benvonhandorf/minstro/README.md

# minstro
Remote control head for SDRs using the SoapyRemote server
