benvonhandorf/minstro/hardware/prototype/minstro_combined_board/minstro_combined_board.kicad_pcb

## KiCad design hardware/prototype/minstro_combined_board/minstro_combined_board.kicad_pcb (2025-06-26)

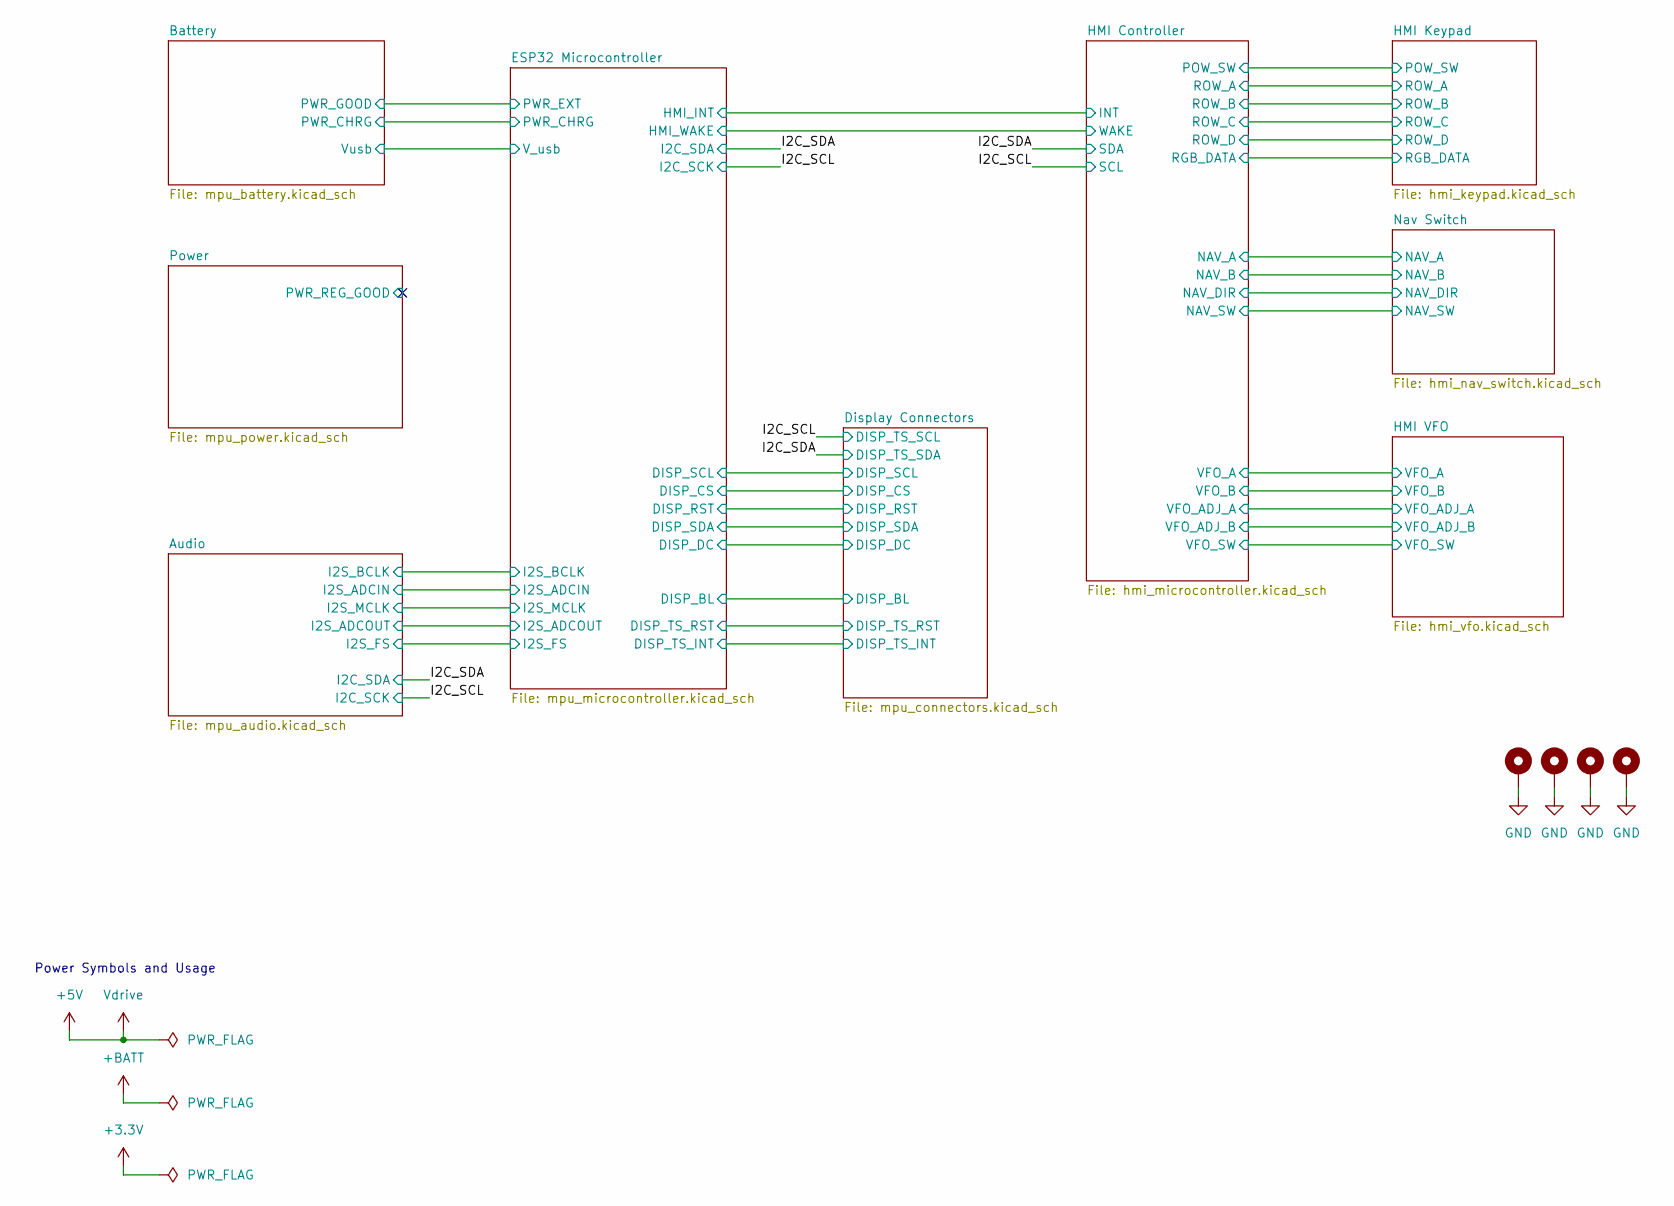
[picture p1: schematic minstro_combined_board.kicad_sch]

Parts:
H101, H102, H103, H104: MountingHole_Pad_MP; MountingHole_3.2mm_M3_Pad

Connections:
GND: H101.1, H102.1, H103.1, H104.1; also elsewhere on the board

Notes on the sheet:
Power Symbols and Usage

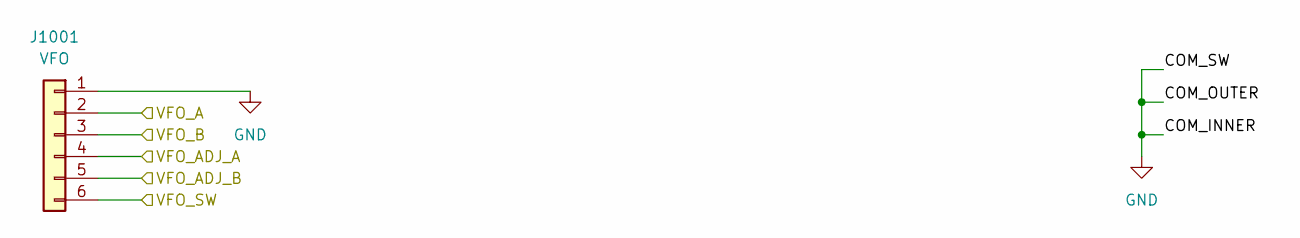
[picture p2: schematic hmi_vfo.kicad_sch]

Parts:
J1001: VFO; PinHeader_1x06_P2.54mm_Vertical

Connections:
/HMI Controller/VFO_A: J1001.2; also elsewhere on the board
/HMI Controller/VFO_ADJ_A: J1001.4; also elsewhere on the board
/HMI Controller/VFO_ADJ_B: J1001.5; also elsewhere on the board
/HMI Controller/VFO_B: J1001.3; also elsewhere on the board
/HMI Controller/VFO_SW: J1001.6; also elsewhere on the board
GND: J1001.1; also elsewhere on the board

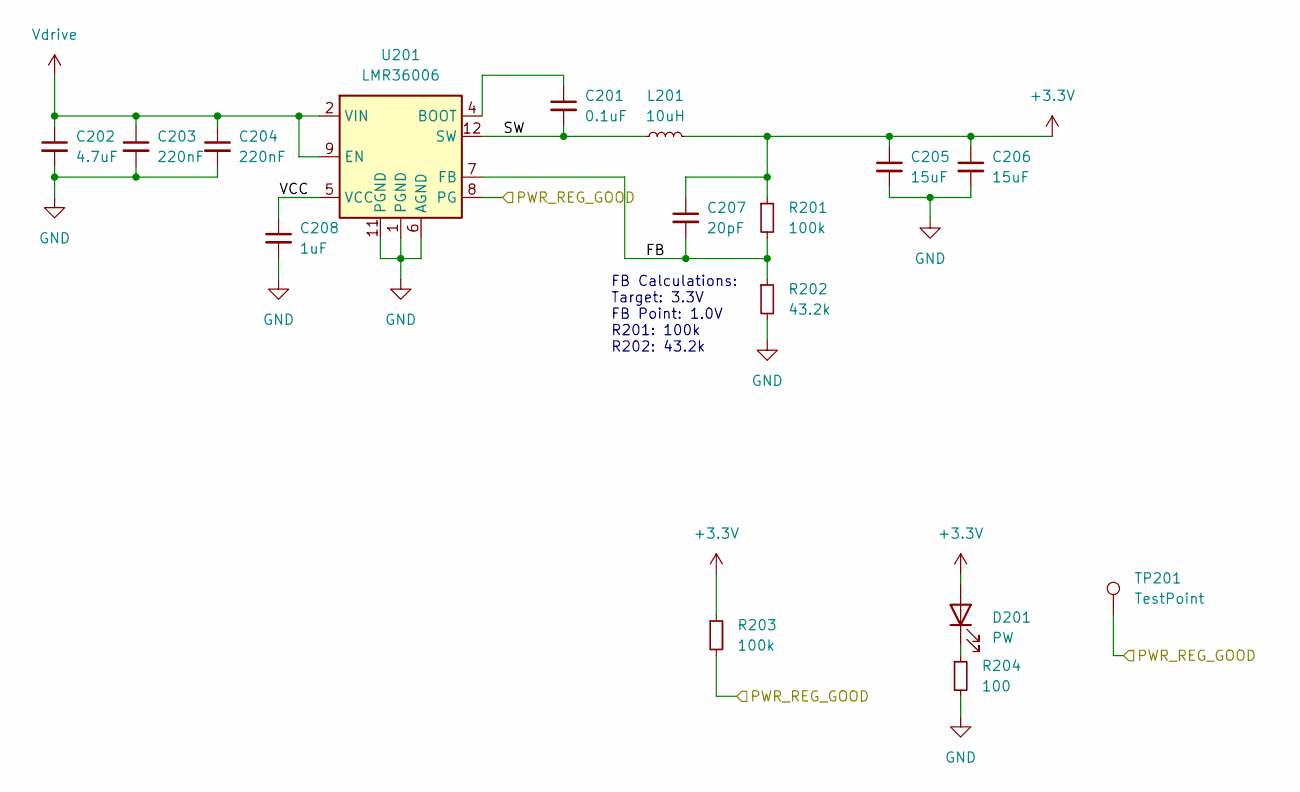
[picture p3: schematic mpu_power.kicad_sch]

Parts:
C201: 0.1uF; C_1206_3216Metric
C202: 4.7uF; C_1206_3216Metric
C203, C204: 220nF; C_1206_3216Metric
C205, C206: 15uF; C_1206_3216Metric
C207: 20pF; C_0805_2012Metric
C208: 1uF; C_0805_2012Metric
D201: PW; LED_0805_2012Metric
L201: 10uH; L_Taiyo-Yuden_MD-4040
R201, R203: 100k; R_0603_1608Metric
R202: 43.2k; R_0603_1608Metric
R204: 100; R_0603_1608Metric
TP201: TestPoint; TestPoint_Pad_D1.5mm
U201: LMR36006; LMR36006-VQFN-HR

Connections:
+3.3V: C205.1, C206.1, C207.1, D201.2 (A), L201.2, R201.1, R203.1; also elsewhere on the board
/Power/FB: C207.2, R201.2, R202.1, U201.7 (FB)
/Power/PWR_REG_GOOD: R203.2, TP201.1, U201.8 (PG)
/Power/SW: C201.2, L201.1, U201.3 (SW), U201.12 (SW)
/Power/VCC: C208.1, U201.5 (VCC)
GND: C202.2, C203.2, C204.2, C205.2, C206.2, C208.2, R202.2, R204.2, U201.1 (PGND), U201.6 (AGND), U201.11 (PGND); also elsewhere on the board
unnamed: D201.1 (K), R204.1
unnamed: C201.1, U201.4 (BOOT)

Notes on the sheet:
FB Calculations: Target: 3.3V FB Point: 1.0V R201: 100k R202: 43.2k

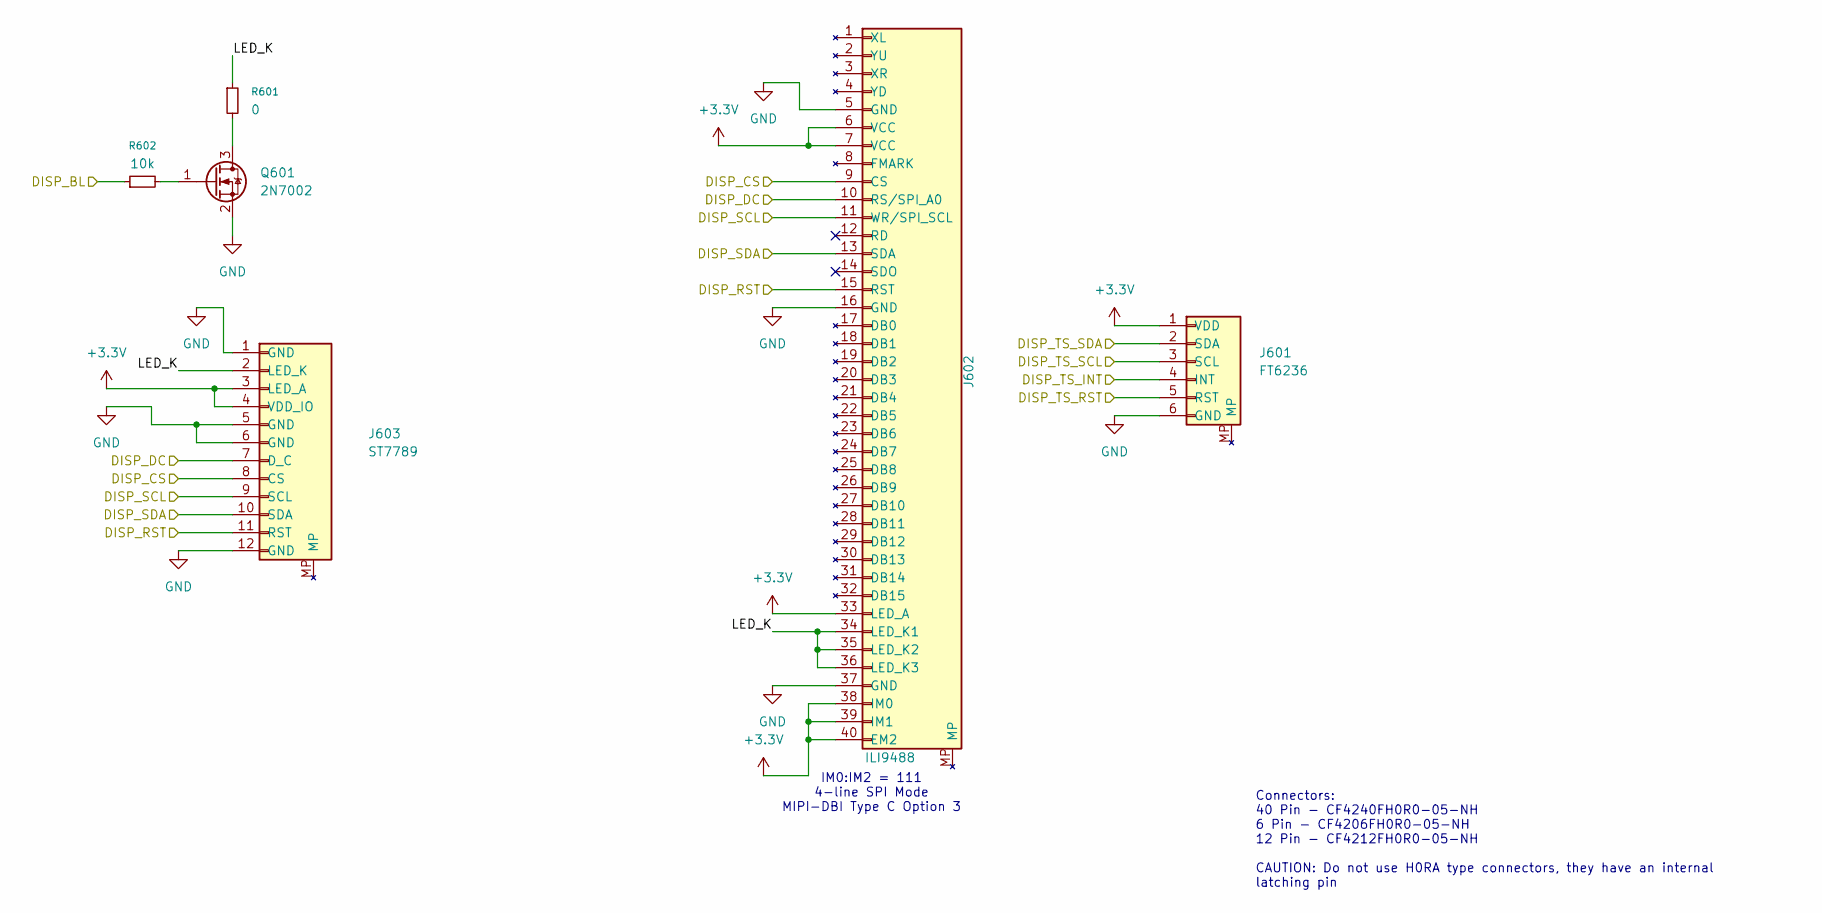
[picture p4: schematic mpu_connectors.kicad_sch]

Parts:
J601: FT6236; Cvilux_CF4206FH0R0-05-NH_FFC_01x06-1MP_P0.5mm_Horizontal
J602: ILI9488; Cvilux_CF4240FH0R0-05-NH_FFC_01x40-1MP_P0.5mm_Horizontal
J603: ST7789; Cvilux_CF4212FH0R0-05-NH_FFC_01x12-1MP_P0.5mm_Horizontal_1
Q601: 2N7002; SOT-23
R601: 0; R_0603_1608Metric_Pad0.98x0.95mm_HandSolder
R602: 10k; R_0603_1608Metric_Pad0.98x0.95mm_HandSolder

Connections:
+3.3V: J601.1 (VDD), J602.6 (VCC), J602.7 (VCC), J602.33 (LED_A), J602.38 (IM0), J602.39 (IM1), J602.40 (EM2), J603.3 (LED_A), J603.4 (VDD_IO); also elsewhere on the board
/Display Connectors/DISP_BL: R602.1; also elsewhere on the board
/Display Connectors/DISP_CS: J602.9 (CS), J603.8 (CS); also elsewhere on the board
/Display Connectors/DISP_DC: J602.10 (RS/SPI_A0), J603.7 (D_C); also elsewhere on the board
/Display Connectors/DISP_RST: J602.15 (RST), J603.11 (RST); also elsewhere on the board
/Display Connectors/DISP_SCL: J602.11 (WR/SPI_SCL), J603.9 (SCL); also elsewhere on the board
/Display Connectors/DISP_SDA: J602.13 (SDA), J603.10 (SDA); also elsewhere on the board
/Display Connectors/DISP_TS_INT: J601.4 (INT); also elsewhere on the board
/Display Connectors/DISP_TS_RST: J601.5 (RST); also elsewhere on the board
/Display Connectors/LED_K: J602.34 (LED_K1), J602.35 (LED_K2), J602.36 (LED_K3), J603.2 (LED_K), R601.1
/I2C_SCL: J601.3 (SCL); also elsewhere on the board
/I2C_SDA: J601.2 (SDA); also elsewhere on the board
GND: J601.6 (GND), J602.5 (GND), J602.16 (GND), J602.37 (GND), J603.1 (GND), J603.5 (GND), J603.6 (GND), J603.12 (GND), Q601.2 (S); also elsewhere on the board
unnamed: Q601.3 (D), R601.2
unnamed: Q601.1 (G), R602.2

Notes on the sheet:
IM0:IM2 = 111 4-line SPI Mode MIPI-DBI Type C Option 3
Connectors: 40 Pin - CF4240FH0R0-05-NH 6 Pin - CF4206FH0R0-05-NH 12 Pin - CF4212FH0R0-05-NH CAUTION: Do not use H0RA type connectors, they have an internal latching pin

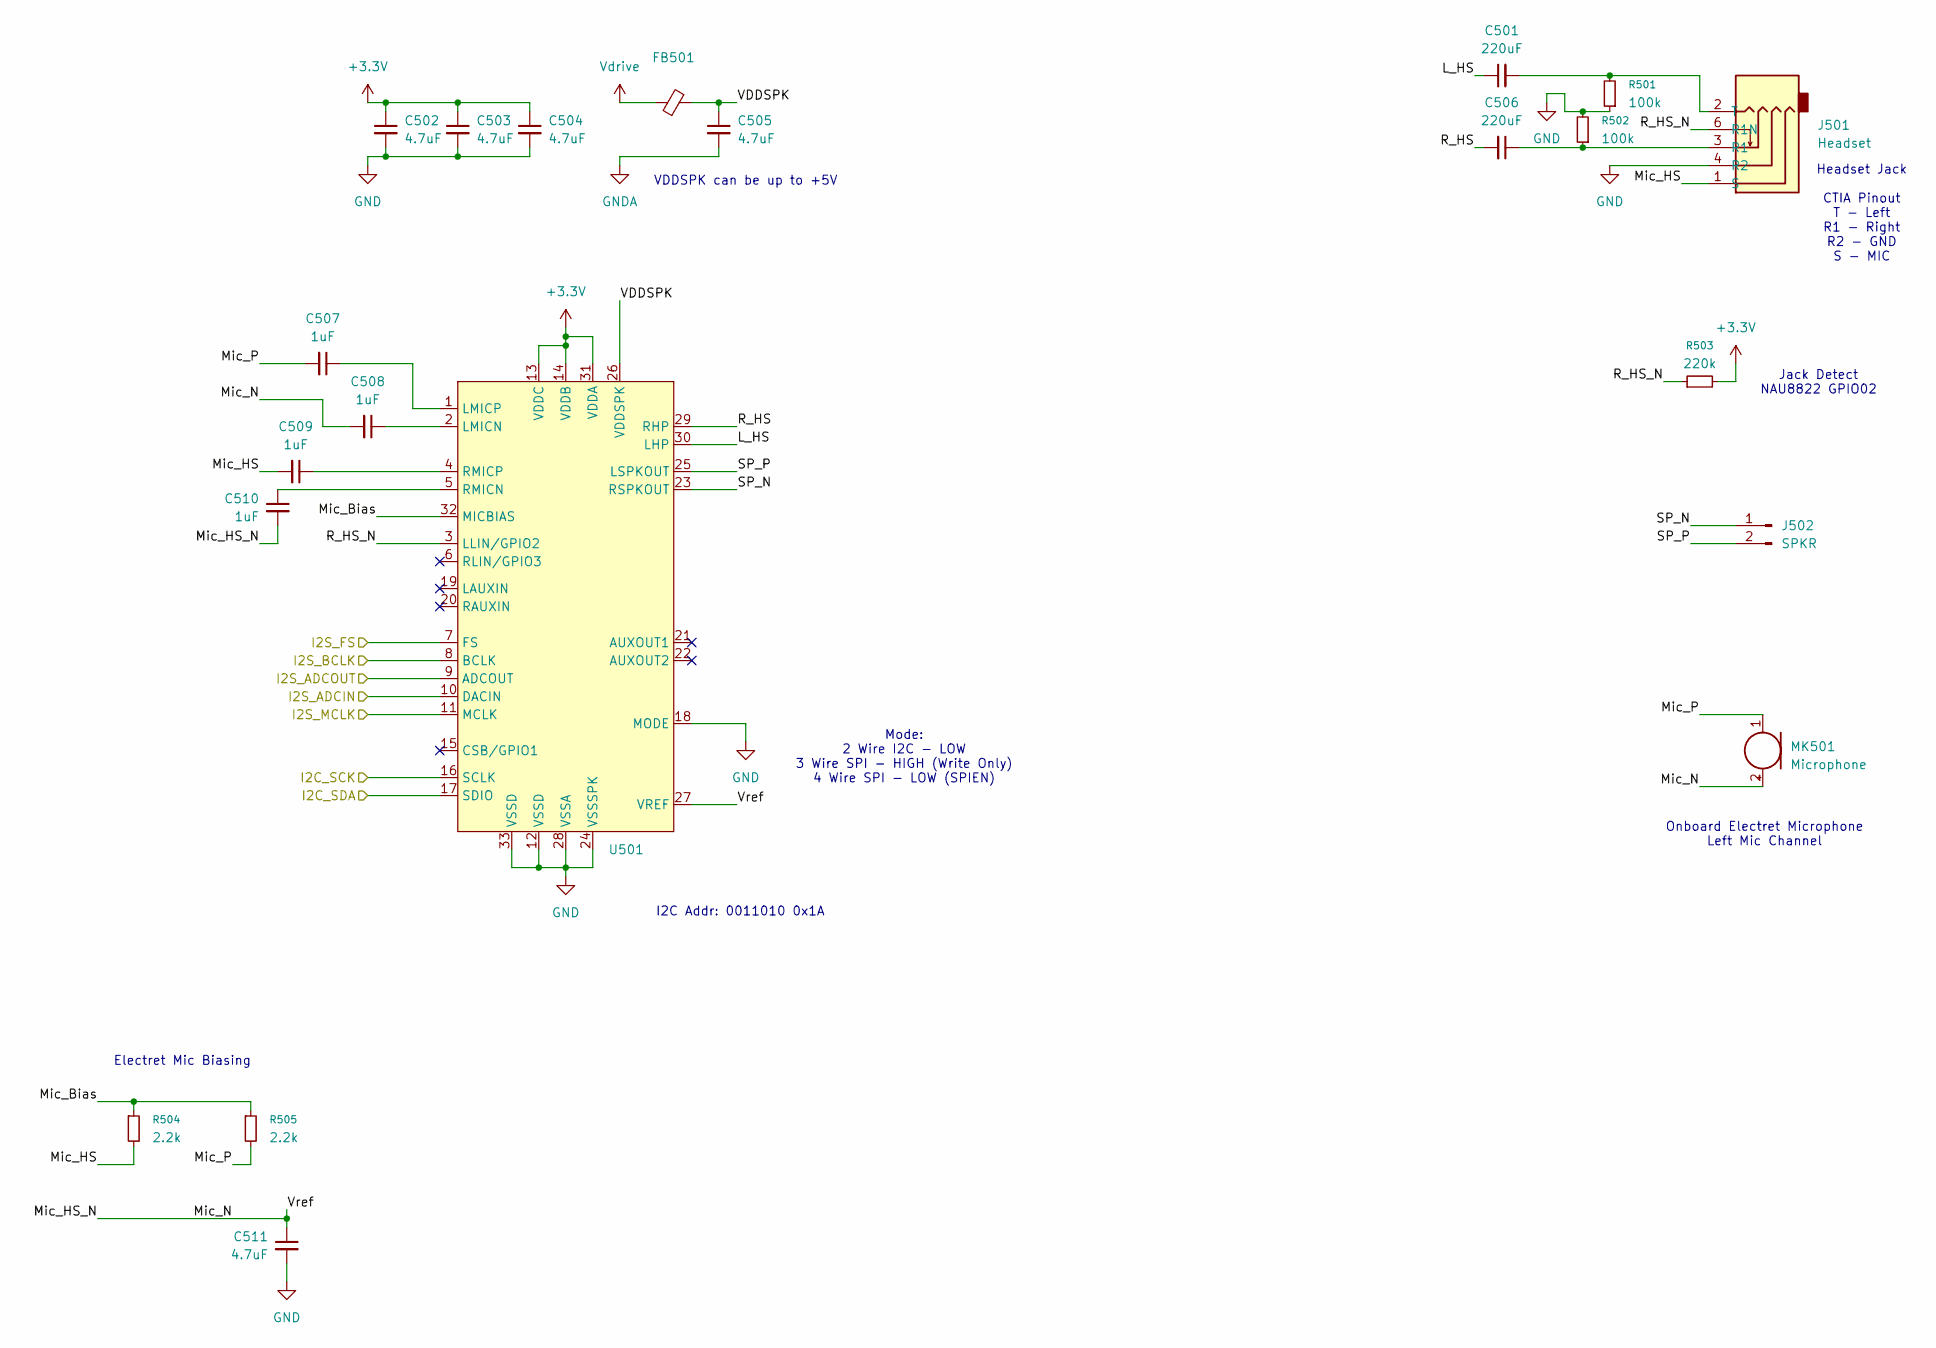
[picture p5: schematic mpu_audio.kicad_sch]

Parts:
C501, C506: 220uF; C_1210_3225Metric
C502, C503, C504, C505, C511: 4.7uF; C_0805_2012Metric
C507, C508, C509, C510: 1uF; C_0603_1608Metric
FB501: FerriteBead_Small; R_0805_2012Metric
J501: Headset; SJ-43515RS-SMT-TR
J502: SPKR; JST_ZH_B2B-ZR_1x02_P1.50mm_Vertical
MK501: Microphone; SameSky_CMB-6544PF_Electret_Mic_9.4d
R501, R502: 100k; R_0603_1608Metric
R503: 220k; R_0603_1608Metric
R504, R505: 2.2k; R_0603_1608Metric
U501: QFN-32-1EP_5x5mm_P0.5mm_EP2.7x2.7mm_ThermalVias

Connections:
+3.3V: C502.1, C503.1, C504.1, R503.2, U501.13 (VDDC), U501.14 (VDDB), U501.31 (VDDA); also elsewhere on the board
/Audio/I2S_ADCIN: U501.10 (DACIN); also elsewhere on the board
/Audio/I2S_ADCOUT: U501.9 (ADCOUT); also elsewhere on the board
/Audio/I2S_BCLK: U501.8 (BCLK); also elsewhere on the board
/Audio/I2S_FS: U501.7 (FS); also elsewhere on the board
/Audio/I2S_MCLK: U501.11 (MCLK); also elsewhere on the board
/Audio/L_HS: C501.1, U501.30 (LHP)
/Audio/Mic_Bias: R504.1, R505.1, U501.32 (MICBIAS)
/Audio/Mic_HS: C509.2, J501.1 (S), R504.2
/Audio/Mic_HS_N: C508.2, C510.2, C511.1, MK501.2 (+), U501.27 (VREF)
/Audio/Mic_P: C507.2, MK501.1 (-), R505.2
/Audio/R_HS: C506.2, U501.29 (RHP)
/Audio/R_HS_N: J501.6 (R1N), R503.1, U501.3 (LLIN/GPIO2)
/Audio/SP_N: J502.1, U501.23 (RSPKOUT)
/Audio/SP_P: J502.2, U501.25 (LSPKOUT)
/Audio/VDDSPK: C505.1, FB501.2, U501.26 (VDDSPK)
/I2C_SCL: U501.16 (SCLK); also elsewhere on the board
/I2C_SDA: U501.17 (SDIO); also elsewhere on the board
GND: C502.2, C503.2, C504.2, C511.2, J501.4 (R2), R501.1, R502.2, U501.12 (VSSD), U501.18 (MODE), U501.24 (VSSSPK), U501.28 (VSSA), U501.33 (VSSD); also elsewhere on the board
GNDA: C505.2
unnamed: C506.1, J501.3 (R1), R502.1
unnamed: C501.2, J501.2 (T), R501.2
unnamed: C508.1, U501.2 (LMICN)
unnamed: C507.1, U501.1 (LMICP)
unnamed: C510.1, U501.5 (RMICN)
unnamed: C509.1, U501.4 (RMICP)

Notes on the sheet:
Onboard Electret Microphone Left Mic Channel
VDDSPK can be up to +5V
Electret Mic Biasing
I2C Addr: 0011010 0x1A
Mode: 2 Wire I2C - LOW 3 Wire SPI - HIGH (Write Only) 4 Wire SPI - LOW (SPIEN)
Headset Jack CTIA Pinout T - Left R1 - Right R2 - GND S - MIC
Jack Detect NAU8822 GPIO02

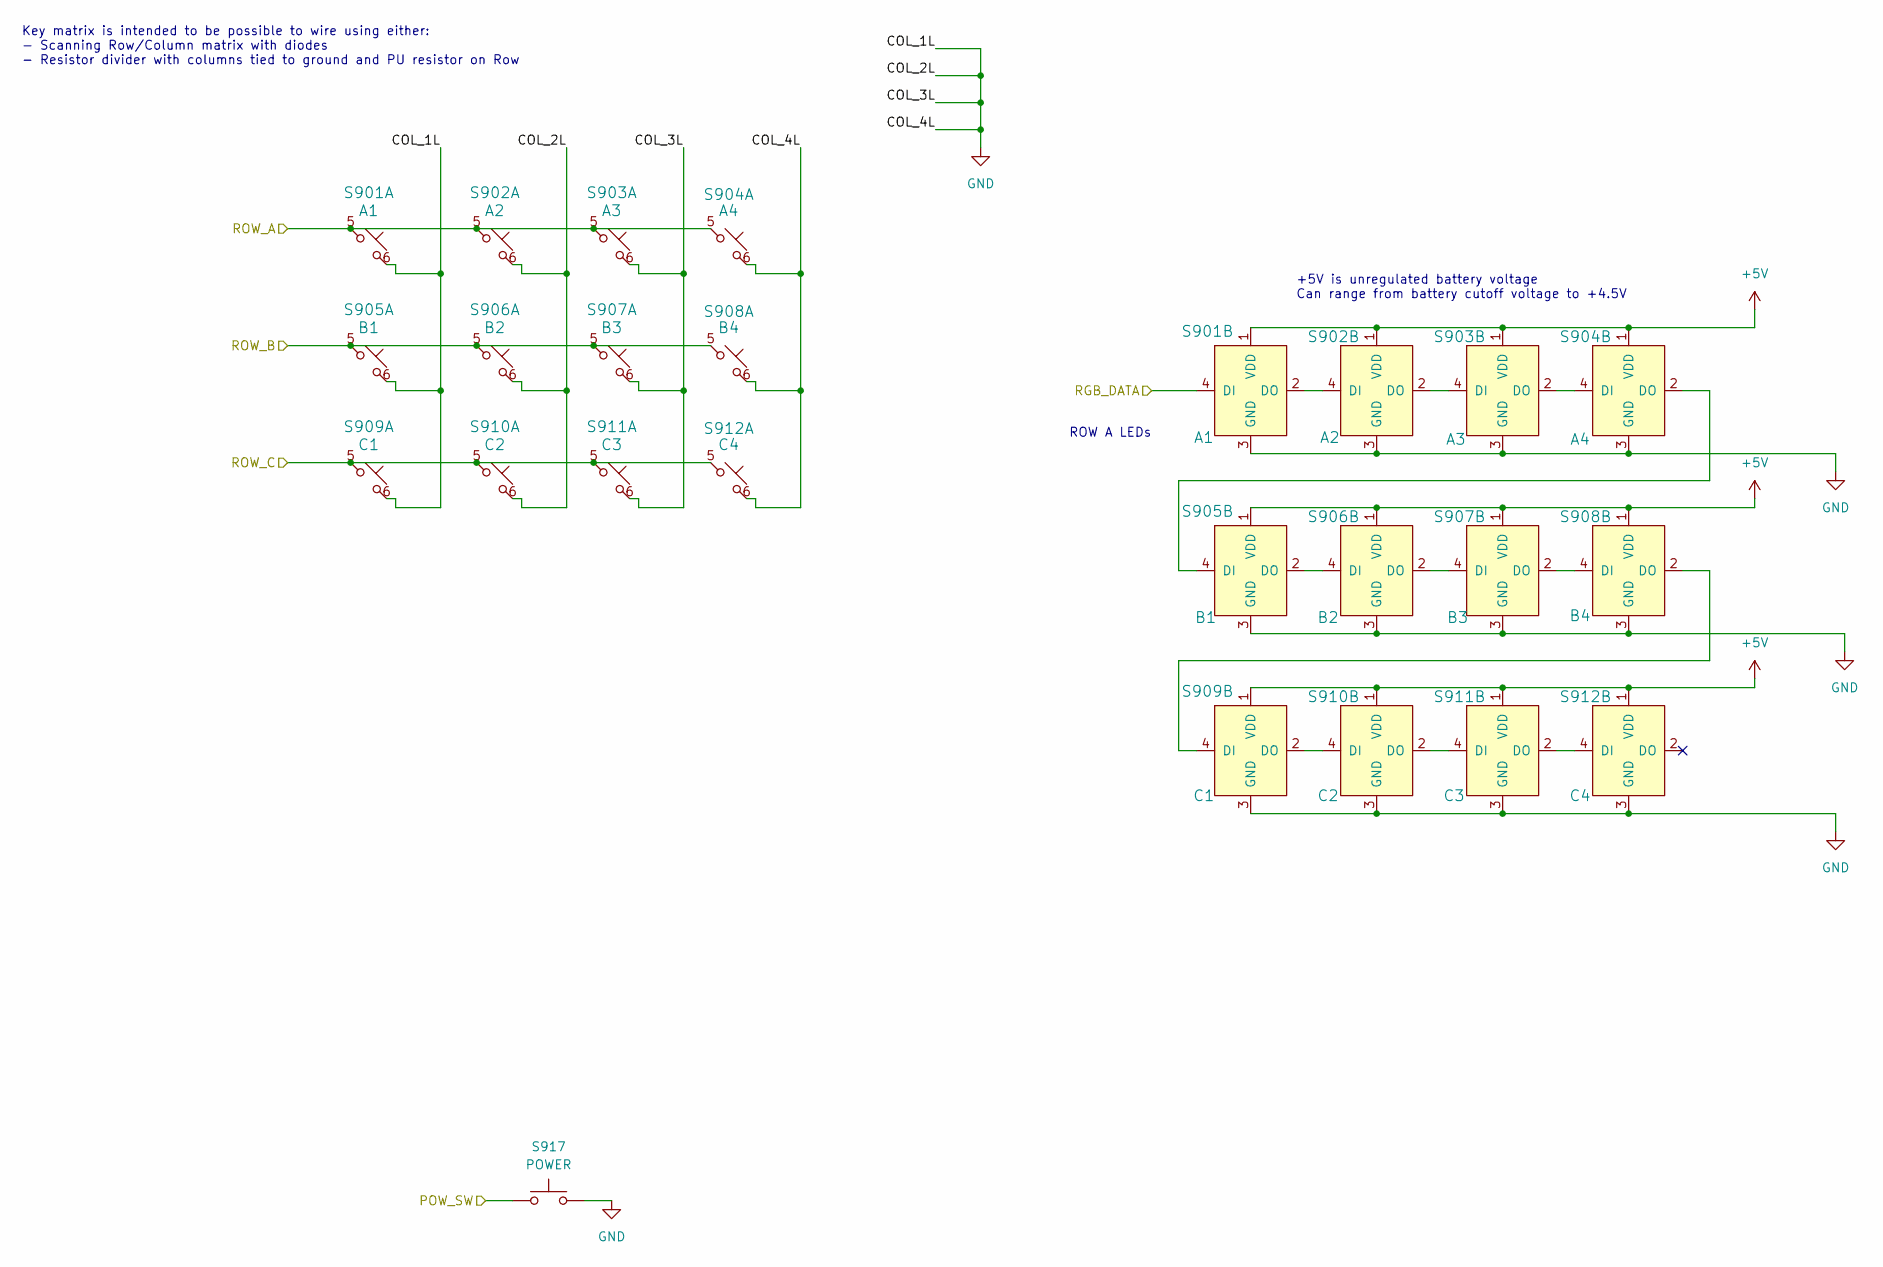
[picture p6: schematic hmi_keypad.kicad_sch]

Parts:
S901: A1; TacButton_6mm_6mm_SK6812-E-Mini
S902: A2; TacButton_6mm_6mm_SK6812-E-Mini
S903: A3; TacButton_6mm_6mm_SK6812-E-Mini
S904: A4; TacButton_6mm_6mm_SK6812-E-Mini
S905: B1; TacButton_6mm_6mm_SK6812-E-Mini
S906: B2; TacButton_6mm_6mm_SK6812-E-Mini
S907: B3; TacButton_6mm_6mm_SK6812-E-Mini
S908: B4; TacButton_6mm_6mm_SK6812-E-Mini
S909: C1; TacButton_6mm_6mm_SK6812-E-Mini
S910: C2; TacButton_6mm_6mm_SK6812-E-Mini
S911: C3; TacButton_6mm_6mm_SK6812-E-Mini
S912: C4; TacButton_6mm_6mm_SK6812-E-Mini
S917: POWER; Tac_SPST_RightAngle_SideActuated_THT

Connections:
/HMI Controller/POW_SW: S917.1; also elsewhere on the board
/HMI Controller/RGB_DATA: S901.4 (DI); also elsewhere on the board
/HMI Controller/ROW_A: S901.5, S902.5, S903.5, S904.5; also elsewhere on the board
/HMI Controller/ROW_B: S905.5, S906.5, S907.5, S908.5; also elsewhere on the board
/HMI Controller/ROW_C: S909.5, S910.5, S911.5, S912.5; also elsewhere on the board
GND: S901.3 (GND), S901.6, S902.3 (GND), S902.6, S903.3 (GND), S903.6, S904.3 (GND), S904.6, S905.3 (GND), S905.6, S906.3 (GND), S906.6, S907.3 (GND), S907.6, S908.3 (GND), S908.6, S909.3 (GND), S909.6, S910.3 (GND), S910.6, S911.3 (GND), S911.6, S912.3 (GND), S912.6, S917.2; also elsewhere on the board
unnamed: S901.2 (DO), S902.4 (DI)
unnamed: S902.2 (DO), S903.4 (DI)
unnamed: S903.2 (DO), S904.4 (DI)
unnamed: S904.2 (DO), S905.4 (DI)
unnamed: S905.2 (DO), S906.4 (DI)
unnamed: S906.2 (DO), S907.4 (DI)
unnamed: S907.2 (DO), S908.4 (DI)
unnamed: S908.2 (DO), S909.4 (DI)
unnamed: S909.2 (DO), S910.4 (DI)
unnamed: S910.2 (DO), S911.4 (DI)
unnamed: S911.2 (DO), S912.4 (DI)

Notes on the sheet:
+5V is unregulated battery voltage Can range from battery cutoff voltage to +4.5V
Key matrix is intended to be possible to wire using either: - Scanning Row/Column matrix with diodes - Resistor divider with columns tied to ground and PU resistor on Row
ROW A LEDs

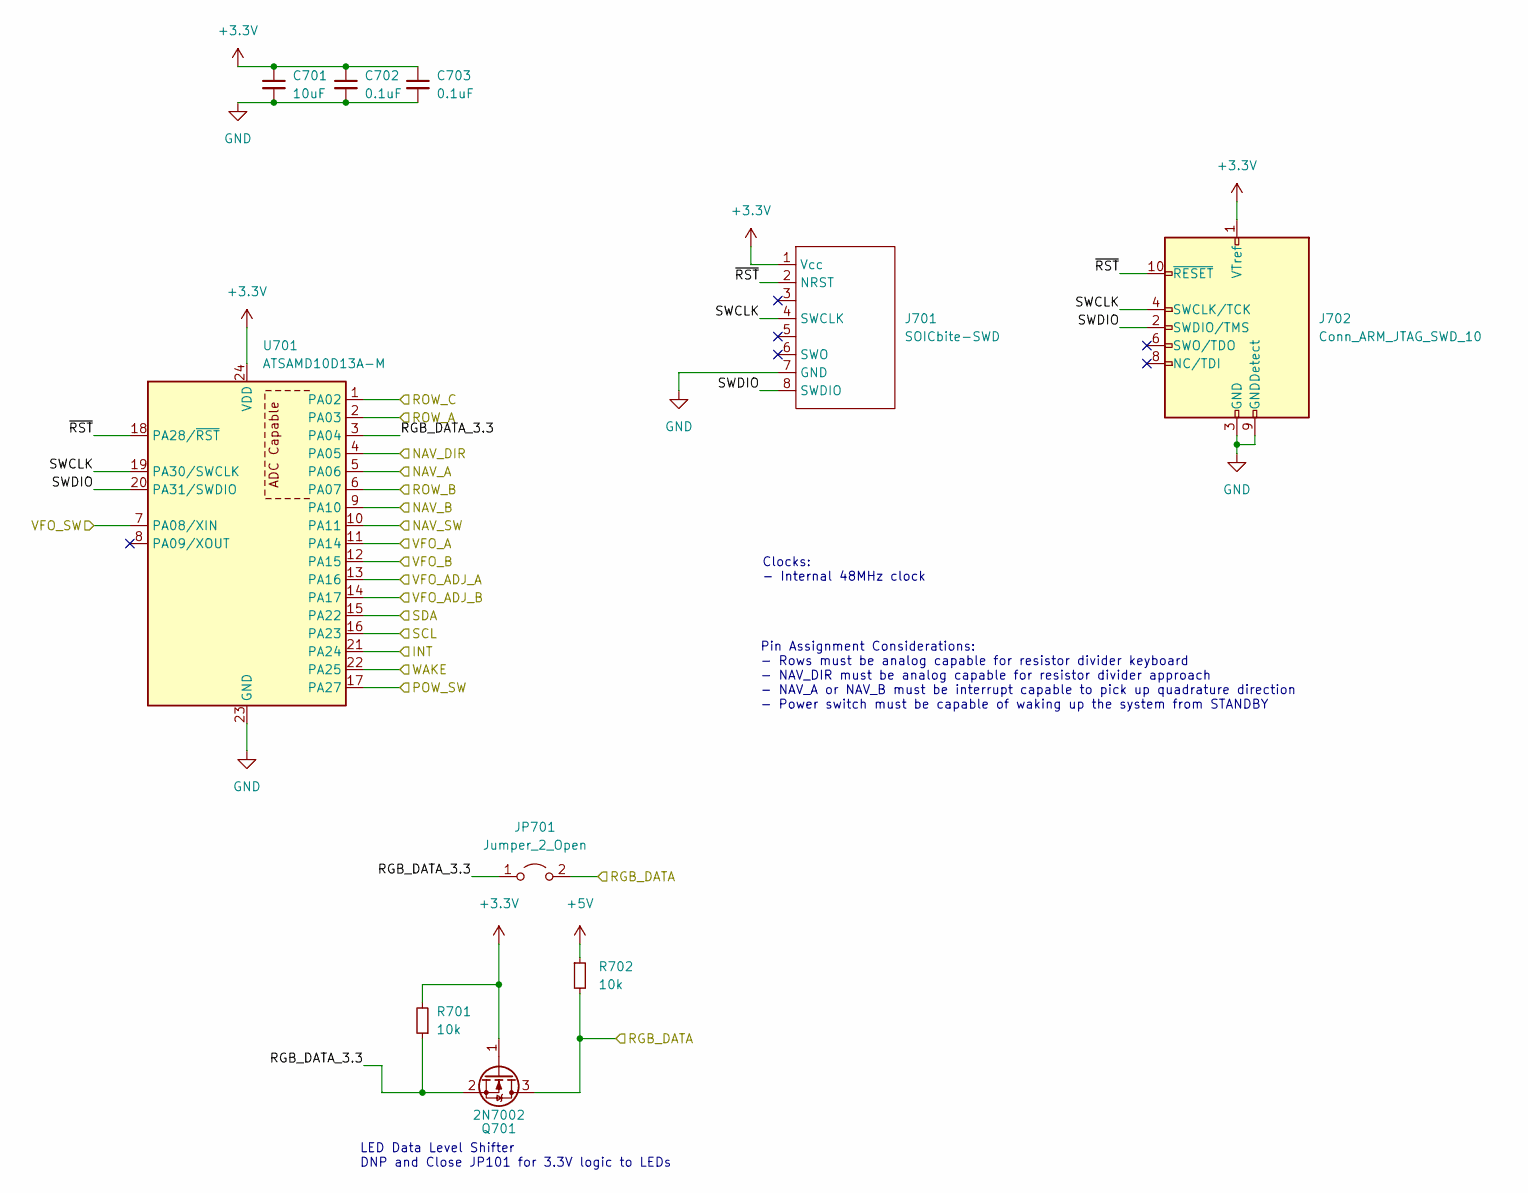
[picture p7: schematic hmi_microcontroller.kicad_sch]

Parts:
C701: 10uF; C_0805_2012Metric
C702, C703: 0.1uF; C_0603_1608Metric
J701: SOICbite-SWD; SOICbite_renumbered
J702: Conn_ARM_JTAG_SWD_10; Cortex_Debug_PinSocket_2x05_P1.27mm_Vertical_SMD
JP701: Jumper_2_Open; SolderJumper-2_P1.3mm_Open_Pad1.0x1.5mm
Q701: 2N7002; SOT-23
R701, R702: 10k; R_0805_2012Metric_Pad1.20x1.40mm_HandSolder
U701: ATSAMD10D13A-M; QFN-24-1EP_4x4mm_P0.5mm_EP2.6x2.6mm_ThermalVias

Connections:
+3.3V: C701.1, C702.1, C703.1, J701.1 (Vcc), J702.1 (VTref), Q701.1 (G), R701.2, U701.24 (VDD); also elsewhere on the board
/ESP32 Microcontroller/HMI_INT: U701.21 (PA24); also elsewhere on the board
/ESP32 Microcontroller/HMI_WAKE: U701.22 (PA25); also elsewhere on the board
/HMI Controller/NAV_A: U701.5 (PA06); also elsewhere on the board
/HMI Controller/NAV_B: U701.9 (PA10); also elsewhere on the board
/HMI Controller/NAV_DIR: U701.4 (PA05); also elsewhere on the board
/HMI Controller/NAV_SW: U701.10 (PA11); also elsewhere on the board
/HMI Controller/POW_SW: U701.17 (PA27); also elsewhere on the board
/HMI Controller/RGB_DATA: JP701.2 (B), Q701.3 (D), R702.2; also elsewhere on the board
/HMI Controller/RGB_DATA_3.3: JP701.1 (A), Q701.2 (S), R701.1, U701.3 (PA04)
/HMI Controller/ROW_A: U701.2 (PA03); also elsewhere on the board
/HMI Controller/ROW_B: U701.6 (PA07); also elsewhere on the board
/HMI Controller/ROW_C: U701.1 (PA02); also elsewhere on the board
/HMI Controller/SWCLK: J701.4 (SWCLK), J702.4 (SWCLK/TCK), U701.19 (PA30/SWCLK)
/HMI Controller/SWDIO: J701.8 (SWDIO), J702.2 (SWDIO/TMS), U701.20 (PA31/SWDIO)
/HMI Controller/VFO_A: U701.11 (PA14); also elsewhere on the board
/HMI Controller/VFO_ADJ_A: U701.13 (PA16); also elsewhere on the board
/HMI Controller/VFO_ADJ_B: U701.14 (PA17); also elsewhere on the board
/HMI Controller/VFO_B: U701.12 (PA15); also elsewhere on the board
/HMI Controller/VFO_SW: U701.7 (PA08/XIN); also elsewhere on the board
/HMI Controller/~RST: J701.2 (NRST), J702.10 (~RESET), U701.18 (PA28/~RST)
/I2C_SCL: U701.16 (PA23); also elsewhere on the board
/I2C_SDA: U701.15 (PA22); also elsewhere on the board
GND: C701.2, C702.2, C703.2, J701.7 (GND), J702.3 (GND), J702.5 (GND), J702.9 (GNDDetect), U701.23 (GND), U701.25 (GND); also elsewhere on the board

Notes on the sheet:
Clocks: - Internal 48MHz clock
LED Data Level Shifter DNP and Close JP101 for 3.3V logic to LEDs
Pin Assignment Considerations: - Rows must be analog capable for resistor divider keyboard - NAV_DIR must be analog capable for resistor divider approach - NAV_A or NAV_B must be interrupt capable to pick up quadrature direction - Power switch must be capable of waking up the system from STANDBY

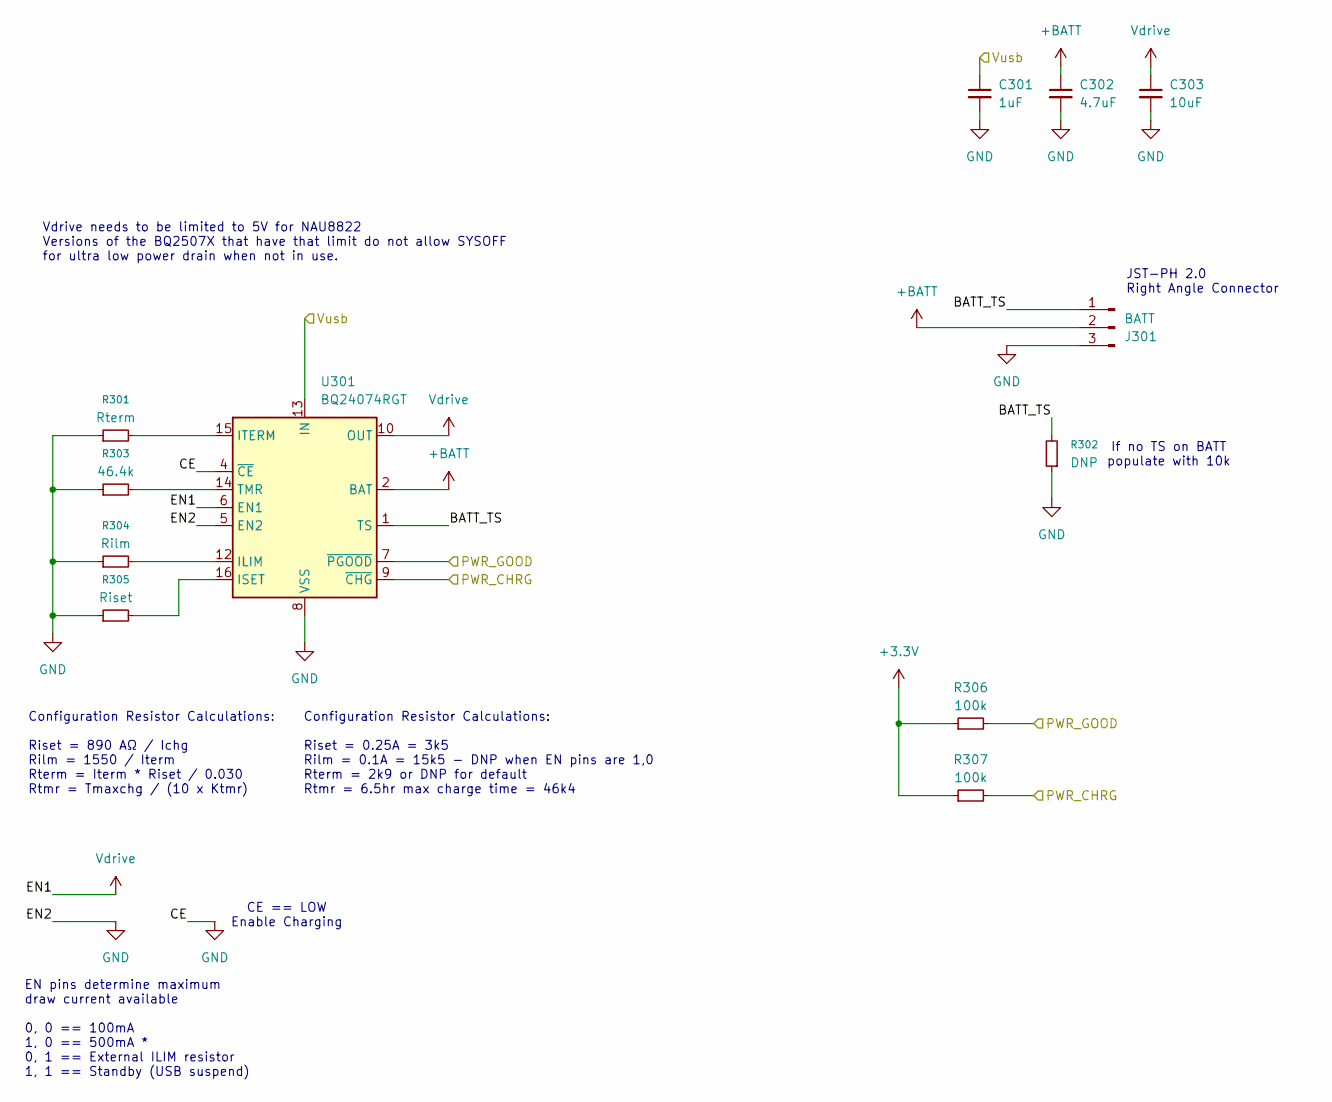
[picture p8: schematic mpu_battery.kicad_sch]

Parts:
C301: 1uF; C_1206_3216Metric
C302: 4.7uF; C_1206_3216Metric
C303: 10uF; C_1206_3216Metric
J301: BATT; JST_PH_S3B-PH-K_1x03_P2.00mm_Horizontal
R301: Rterm; R_0603_1608Metric
R302: DNP; R_0603_1608Metric
R303: 46.4k; R_0603_1608Metric
R304: Rilm; R_0603_1608Metric
R305: Riset; R_0603_1608Metric
R306, R307: 100k; R_0603_1608Metric
U301: BQ24074RGT; VQFN-16-1EP_3x3mm_P0.5mm_EP1.6x1.6mm_ThermalVias

Connections:
+3.3V: R306.1, R307.1; also elsewhere on the board
+BATT: C302.1, J301.2, U301.2 (BAT), U301.3 (BAT)
/Battery/BATT_TS: J301.1, R302.2, U301.1 (TS)
/Battery/PWR_CHRG: R307.2, U301.9 (~CHG); also elsewhere on the board
/Battery/PWR_GOOD: R306.2, U301.7 (~PGOOD); also elsewhere on the board
/Battery/Vusb: C301.1, U301.13 (IN); also elsewhere on the board
GND: C301.2, C302.2, C303.2, J301.3, R301.1, R302.1, R303.1, R304.1, R305.1, U301.4 (~CE), U301.5 (EN2), U301.8 (VSS), U301.17 (VSS); also elsewhere on the board
unnamed: R304.2, U301.12 (ILIM)
unnamed: R305.2, U301.16 (ISET)
unnamed: R301.2, U301.15 (ITERM)
unnamed: R303.2, U301.14 (TMR)

Notes on the sheet:
Configuration Resistor Calculations: Riset = 0.25A = 3k5 Rilm = 0.1A = 15k5 - DNP when EN pins are 1,0 Rterm = 2k9 or DNP for default Rtmr = 6.5hr max charge time = 46k4
JST-PH 2.0 Right Angle Connector
EN pins determine maximum draw current available 0, 0 == 100mA 1, 0 == 500mA * 0, 1 == External ILIM resistor 1, 1 == Standby (USB suspend)
Vdrive needs to be limited to 5V for NAU8822 Versions of the BQ2507X that have that limit do not allow SYSOFF for ultra low power drain when not in use.
If no TS on BATT populate with 10k
Configuration Resistor Calculations: Riset = 890 AΩ / Ichg Rilm = 1550 / Iterm Rterm = Iterm * Riset / 0.030 Rtmr = Tmaxchg / (10 x Ktmr)
CE == LOW Enable Charging
