benvonhandorf/minstro/hardware/prototype/minstro_combined_board/minstro_combined_board.kicad_pcb

## KiCad design hardware/prototype/minstro_combined_board/minstro_combined_board.kicad_pcb (continued)

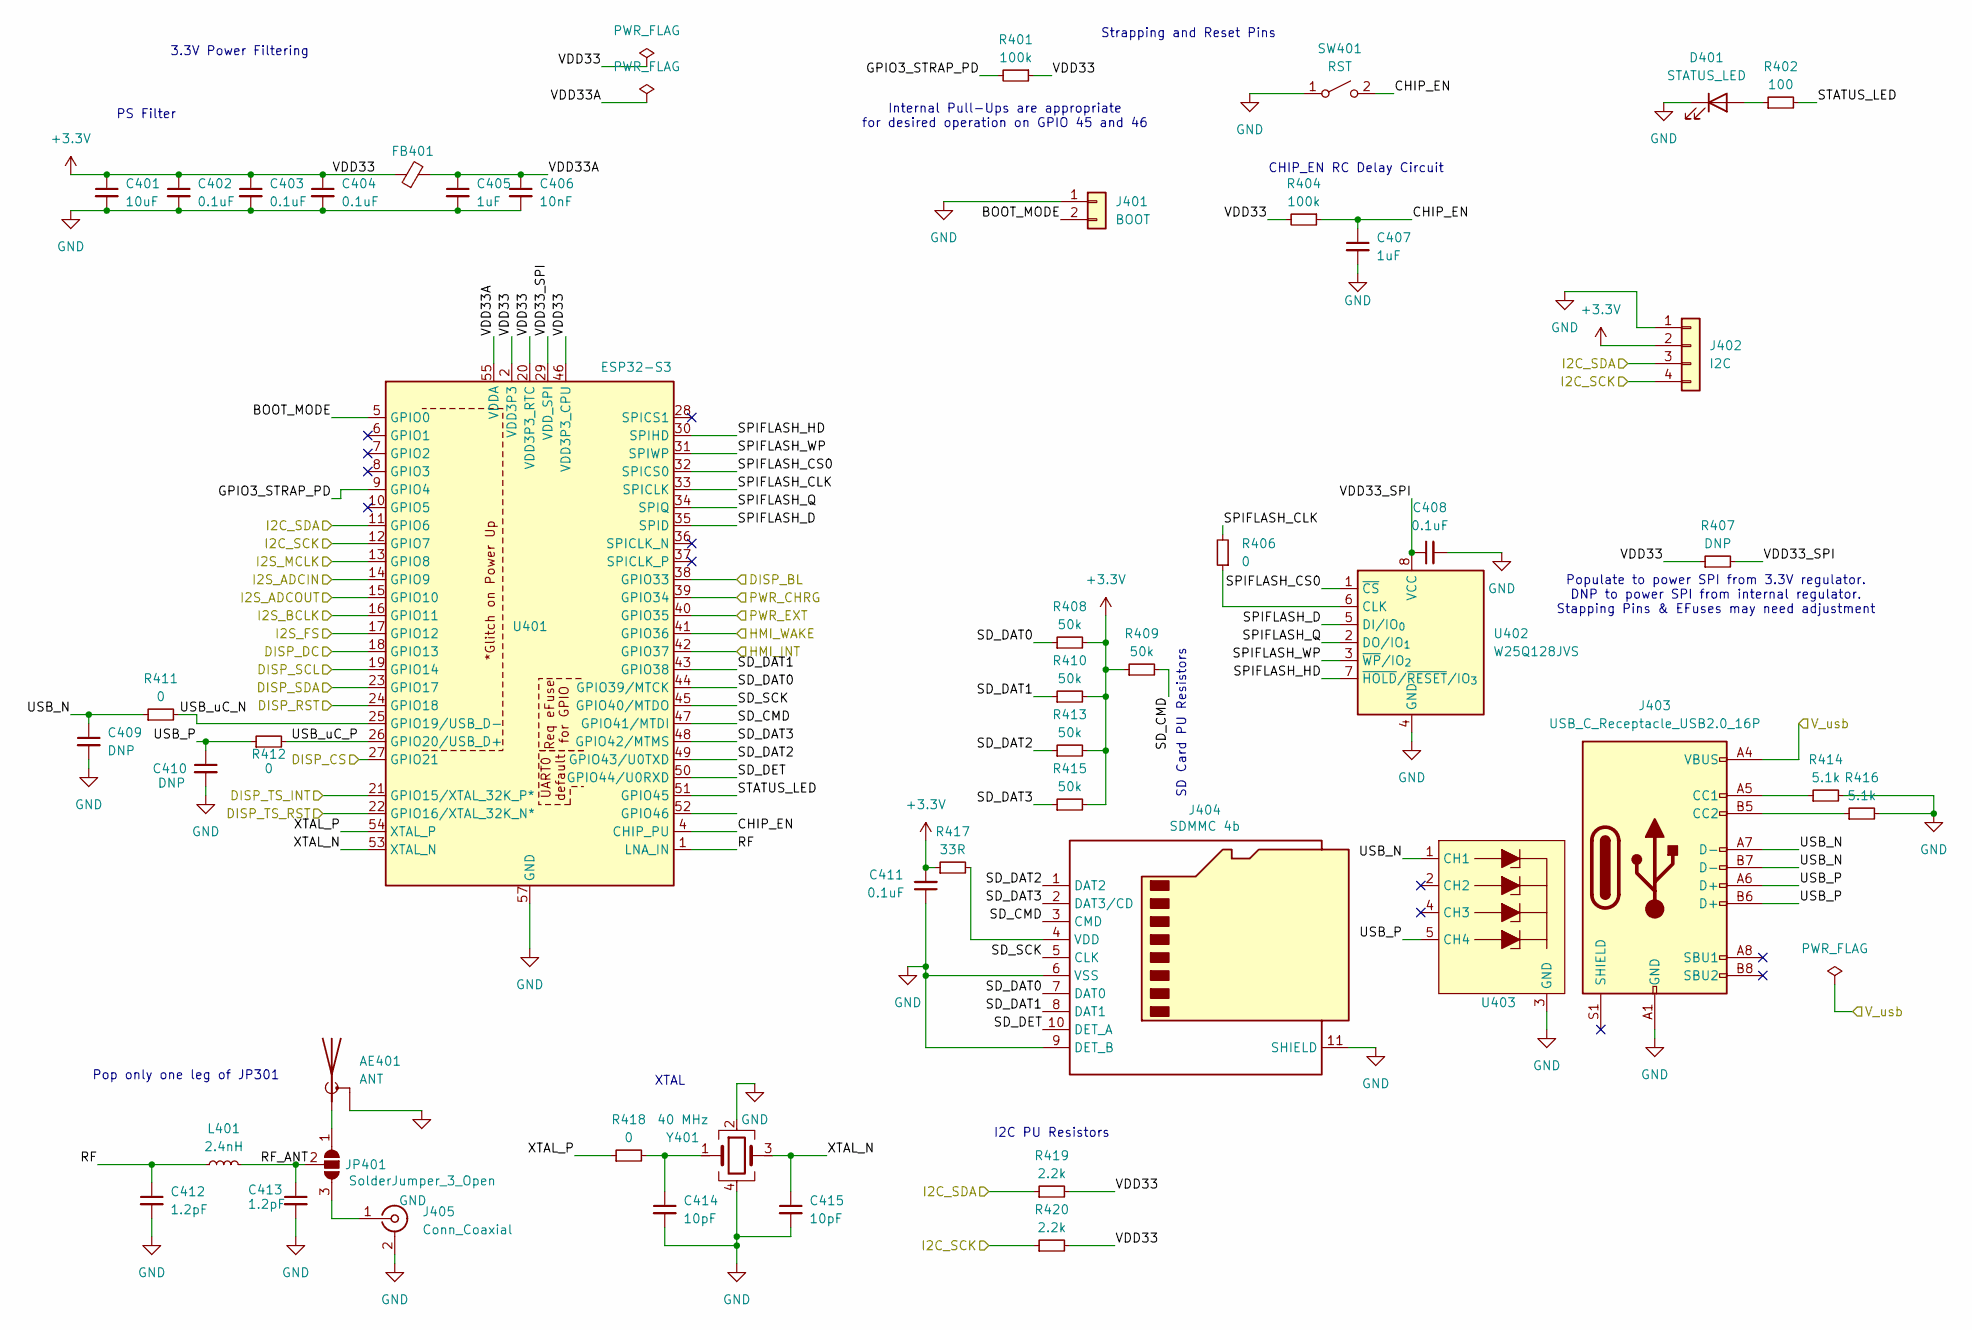
[picture p9: schematic mpu_microcontroller.kicad_sch]

Parts:
AE401: ANT; ANT2012LL13R2400A
C401: 10uF; C_0805_2012Metric
C402, C403, C404, C408, C411: 0.1uF; C_0603_1608Metric
C405: 1uF; C_0603_1608Metric
C406: 10nF; C_0603_1608Metric
C407: 1uF; C_0805_2012Metric
C409, C410: DNP; C_0603_1608Metric
C412, C413: 1.2pF; C_0603_1608Metric
C414, C415: 10pF; C_0603_1608Metric
D401: STATUS_LED; LED_0805_2012Metric
FB401: R_0805_2012Metric
J401: BOOT; PinHeader_1x02_P2.54mm_Vertical
J402: I2C; PinHeader_1x04_P2.54mm_Vertical
J403: USB_C_Receptacle_USB2.0_16P; USB_C_Receptacle_GCT_USB4085_PinPaste
J404: SDMMC 4b; MicroSD_Socket_Unbranded
J405: Conn_Coaxial; U.FL_Molex_MCRF_73412-0110_Vertical
JP401: SolderJumper_3_Open; Jumper_Resistor_0603_2_Way
L401: 2.4nH; L_0603_1608Metric
R401, R404: 100k; R_0603_1608Metric
R402: 100; R_0603_1608Metric
R406, R411, R412, R418: 0; R_0603_1608Metric
R407: DNP; R_0603_1608Metric
R408, R409, R410, R413, R415: 50k; R_0603_1608Metric
R414, R416: 5.1k; R_0603_1608Metric
R417: 33R; R_0603_1608Metric
R419, R420: 2.2k; R_0805_2012Metric
SW401: RST; Tac_SMD_6.4mm_Side_SPST_NO
U401: ESP32-S3; QFN-56-1EP_7x7mm_P0.4mm_EP4x4mm_ThermalVias
U402: W25Q128JVS; SOIC-8_5.3x5.3mm_P1.27mm
U403: Diode_10Pin_DFN2510A-10_10-XFDFN_SOT1176-1
Y401: 40 MHz; Crystal_SMD_2016-4Pin_2.0x1.6mm

Connections:
+3.3V: C401.1, C402.1, C403.1, C404.1, C411.2, FB401.1, J402.2, R401.1, R404.2, R407.1, R408.2, R409.1, R410.2, R413.2, R415.2, R417.1, R419.2, R420.2, U401.2 (VDD3P3), U401.3 (VDD3P3), U401.20 (VDD3P3_RTC), U401.46 (VDD3P3_CPU); also elsewhere on the board
/Audio/I2S_ADCIN: U401.14 (GPIO9); also elsewhere on the board
/Audio/I2S_ADCOUT: U401.15 (GPIO10); also elsewhere on the board
/Audio/I2S_BCLK: U401.16 (GPIO11); also elsewhere on the board
/Audio/I2S_FS: U401.17 (GPIO12); also elsewhere on the board
/Audio/I2S_MCLK: U401.13 (GPIO8); also elsewhere on the board
/Battery/PWR_CHRG: U401.39 (GPIO34); also elsewhere on the board
/Battery/PWR_GOOD: U401.40 (GPIO35); also elsewhere on the board
/Battery/Vusb: J403.A4 (VBUS), J403.A9 (VBUS), J403.B4 (VBUS), J403.B9 (VBUS); also elsewhere on the board
/Display Connectors/DISP_BL: U401.38 (GPIO33); also elsewhere on the board
/Display Connectors/DISP_CS: U401.27 (GPIO21); also elsewhere on the board
/Display Connectors/DISP_DC: U401.18 (GPIO13); also elsewhere on the board
/Display Connectors/DISP_RST: U401.24 (GPIO18); also elsewhere on the board
/Display Connectors/DISP_SCL: U401.19 (GPIO14); also elsewhere on the board
/Display Connectors/DISP_SDA: U401.23 (GPIO17); also elsewhere on the board
/Display Connectors/DISP_TS_INT: U401.21 (GPIO15/XTAL_32K_P*); also elsewhere on the board
/Display Connectors/DISP_TS_RST: U401.22 (GPIO16/XTAL_32K_N*); also elsewhere on the board
/ESP32 Microcontroller/BOOT_MODE: J401.2, U401.5 (GPIO0)
/ESP32 Microcontroller/CHIP_EN: C407.1, R404.1, SW401.2 (B), U401.4 (CHIP_PU)
/ESP32 Microcontroller/GPIO3_STRAP_PD: R401.2, U401.9 (GPIO4)
/ESP32 Microcontroller/HMI_INT: U401.42 (GPIO37); also elsewhere on the board
/ESP32 Microcontroller/HMI_WAKE: U401.41 (GPIO36); also elsewhere on the board
/ESP32 Microcontroller/RF: C412.1, L401.1, U401.1 (LNA_IN)
/ESP32 Microcontroller/RF_ANT: C413.1, JP401.2 (C), L401.2
/ESP32 Microcontroller/SD_CMD: J404.3 (CMD), R409.2, U401.47 (GPIO41/MTDI)
/ESP32 Microcontroller/SD_DAT0: J404.7 (DAT0), R408.1, U401.44 (GPIO39/MTCK)
/ESP32 Microcontroller/SD_DAT1: J404.8 (DAT1), R410.1, U401.43 (GPIO38)
/ESP32 Microcontroller/SD_DAT2: J404.1 (DAT2), R413.1, U401.49 (GPIO43/U0TXD)
/ESP32 Microcontroller/SD_DAT3: J404.2 (DAT3/CD), R415.1, U401.48 (GPIO42/MTMS)
/ESP32 Microcontroller/SD_DET: J404.10 (DET_A), U401.50 (GPIO44/U0RXD)
/ESP32 Microcontroller/SD_SCK: J404.5 (CLK), U401.45 (GPIO40/MTDO)
/ESP32 Microcontroller/SPIFLASH_CLK: R406.2, U401.33 (SPICLK)
/ESP32 Microcontroller/SPIFLASH_CS0: U401.32 (SPICS0), U402.1 (~CS)
/ESP32 Microcontroller/SPIFLASH_D: U401.35 (SPID), U402.5 (DI/IO_{0})
/ESP32 Microcontroller/SPIFLASH_HD: U401.30 (SPIHD), U402.7 (~HOLD/~RESET/IO_{3})
/ESP32 Microcontroller/SPIFLASH_Q: U401.34 (SPIQ), U402.2 (DO/IO_{1})
/ESP32 Microcontroller/SPIFLASH_WP: U401.31 (SPIWP), U402.3 (~WP/IO_{2})
/ESP32 Microcontroller/STATUS_LED: R402.2, U401.51 (GPIO45)
/ESP32 Microcontroller/USB_N: C409.1, J403.A7 (D-), J403.B7 (D-), R411.1, U403.1 (CH1)
/ESP32 Microcontroller/USB_P: C410.1, J403.A6 (D+), J403.B6 (D+), R412.1, U403.5 (CH4)
/ESP32 Microcontroller/USB_uC_N: R411.2, U401.25 (GPIO19/USB_D-)
/ESP32 Microcontroller/USB_uC_P: R412.2, U401.26 (GPIO20/USB_D+)
/ESP32 Microcontroller/VDD33A: C405.1, C406.1, FB401.2, U401.55 (VDDA), U401.56 (VDDA)
/ESP32 Microcontroller/VDD33_SPI: C408.1, R407.2, U401.29 (VDD_SPI), U402.8 (VCC)
/ESP32 Microcontroller/XTAL_N: C415.1, U401.53 (XTAL_N), Y401.3
/ESP32 Microcontroller/XTAL_P: R418.1, U401.54 (XTAL_P)
/I2C_SCL: J402.4, R420.1, U401.12 (GPIO7); also elsewhere on the board
/I2C_SDA: J402.3, R419.1, U401.11 (GPIO6); also elsewhere on the board
GND: AE401.2 (GND), C401.2, C402.2, C403.2, C404.2, C405.2, C406.2, C407.2, C408.2, C409.2, C410.2, C411.1, C412.2, C413.2, C414.2, C415.2, D401.1 (K), J401.1, J402.1, J403.A1 (GND), J403.A12 (GND), J403.B1 (GND), J403.B12 (GND), J404.6 (VSS), J404.9 (DET_B), J404.11 (SHIELD), J405.2 (Ext), R414.2, R416.2, SW401.1 (A), U401.57 (GND), U402.4 (GND), U403.3 (GND), U403.8 (GND), Y401.2, Y401.4; also elsewhere on the board
unnamed: AE401.1 (A), JP401.1 (A)
unnamed: C414.1, R418.2, Y401.1
unnamed: D401.2 (A), R402.1
unnamed: J403.A5 (CC1), R414.1
unnamed: J403.B5 (CC2), R416.1
unnamed: J404.4 (VDD), R417.2
unnamed: J405.1 (In), JP401.3 (B)
unnamed: R406.1, U402.6 (CLK)

Notes on the sheet:
Internal Pull-Ups are appropriate for desired operation on GPIO 45 and 46
3.3V Power Filtering
I2C PU Resistors
CHIP_EN RC Delay Circuit
SD Card PU Resistors
Strapping and Reset Pins
Pop only one leg of JP301
XTAL
PS Filter
Populate to power SPI from 3.3V regulator. DNP to power SPI from internal regulator. Stapping Pins & EFuses may need adjustment

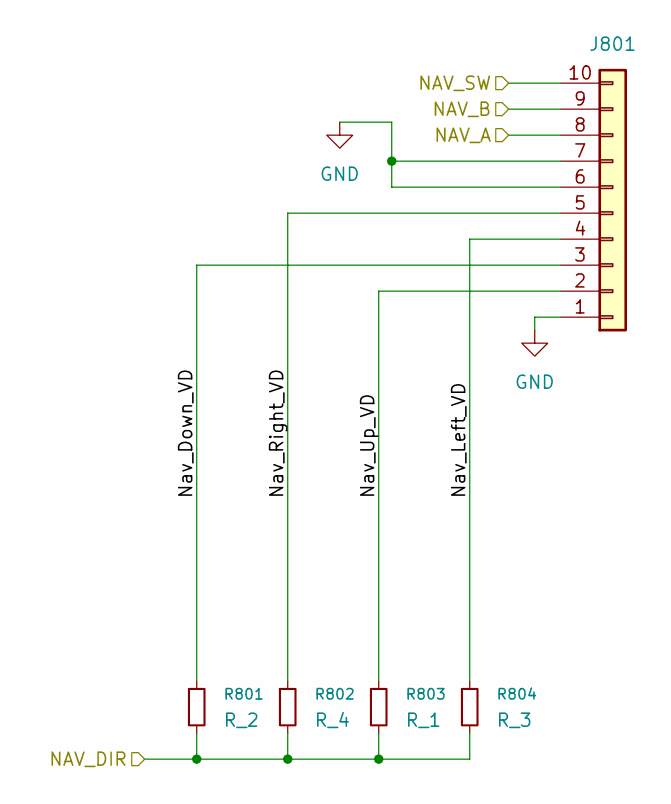
[picture p10: schematic hmi_nav_switch.kicad_sch]

Parts:
J801: NAV CONN; PinHeader_1x10_P2.54mm_Vertical
R801: R_2; R_0603_1608Metric
R802: R_4; R_0603_1608Metric
R803: R_1; R_0603_1608Metric
R804: R_3; R_0603_1608Metric

Connections:
/HMI Controller/NAV_A: J801.8; also elsewhere on the board
/HMI Controller/NAV_B: J801.9; also elsewhere on the board
/HMI Controller/NAV_DIR: R801.2, R802.2, R803.2, R804.2; also elsewhere on the board
/HMI Controller/NAV_SW: J801.10; also elsewhere on the board
/Nav Switch/Nav_Down_VD: J801.3, R801.1
/Nav Switch/Nav_Left_VD: J801.4, R804.1
/Nav Switch/Nav_Right_VD: J801.5, R802.1
/Nav Switch/Nav_Up_VD: J801.2, R803.1
GND: J801.1, J801.6, J801.7; also elsewhere on the board

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
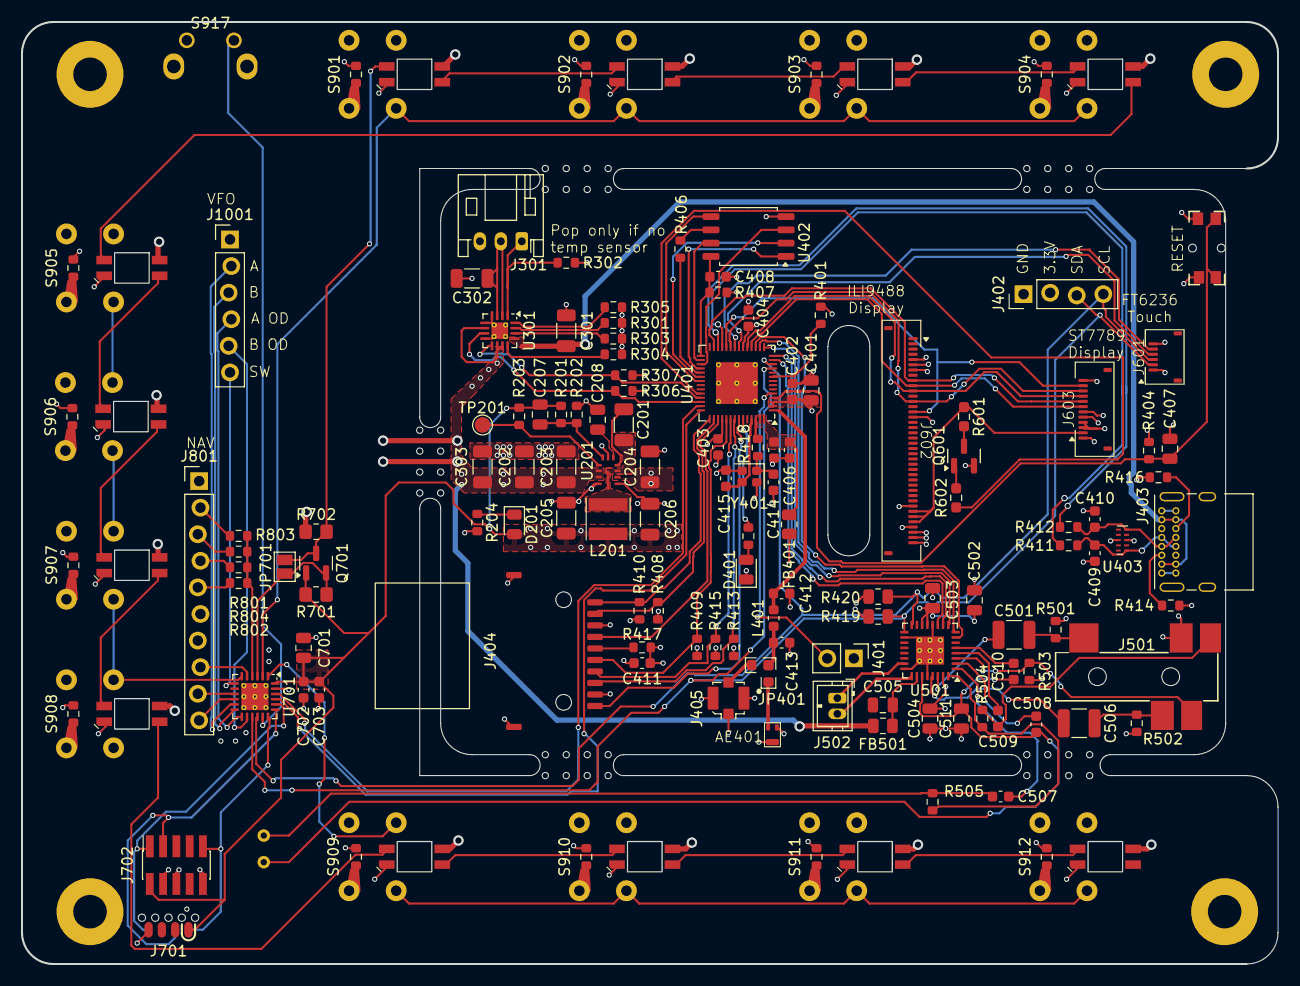
[picture p11: board minstro_combined_board.kicad_pcb from above]

Board: 4 copper layers, 120.0 x 90.0 mm, 136 parts (1 on the bottom side), 122 nets.
