benvonhandorf/minstro/(commit log)

2025-05-20 Initial HMI board schematic work
    [hmi_board.kicad_pcb, hmi_board.kicad_sch, hmi_keypad.kicad_sch, hmi_microcontroller.kicad_sch, hmi_nav_switch.kicad_sch]
2025-05-20 Added column jumpers
    [hmi_keypad.kicad_sch]
2025-05-24 Add display board
    [display_board.kicad_pcb, display_board.kicad_sch, display_connectors.kicad_sch, display_microcontroller.kicad_sch, hmi_keypad.kicad_sch, hmi_microcontroller.kicad_sch]
2025-06-02 Combined board started
    [display_battery.kicad_sch, display_board.kicad_sch, hmi_board.kicad_sch, hmi_keypad.kicad_sch, hmi_microcontroller.kicad_sch, hmi_nav_switch.kicad_sch, hmi_vfo.kicad_sch, mcu_power.kicad_sch]
2025-06-05 Combined board started layout
    [hmi_keypad.kicad_sch, hmi_microcontroller.kicad_sch, hmi_nav_switch.kicad_sch, hmi_vfo.kicad_sch, minstro_combined_board.kicad_pcb, mpu_audio.kicad_sch, mpu_battery.kicad_sch, mpu_connectors.kicad_sch]
2025-06-06 Schematic ERC complete
    [hmi_keypad.kicad_sch, hmi_microcontroller.kicad_sch, hmi_nav_switch.kicad_sch, hmi_vfo.kicad_sch, minstro_combined_board.kicad_sch, mpu_connectors.kicad_sch, mpu_microcontroller.kicad_sch]
2025-06-06 Footprint assignment and PCB layout work
    [hmi_keypad.kicad_sch, hmi_nav_switch.kicad_sch, minstro_combined_board.kicad_pcb, mpu_audio.kicad_sch]
2025-06-08 Layout WIP
    [hmi_keypad.kicad_sch, hmi_nav_switch.kicad_sch, hmi_vfo.kicad_sch, minstro_combined_board.kicad_pcb, minstro_combined_board.kicad_sch, mpu_audio.kicad_sch, mpu_microcontroller.kicad_sch]
2025-06-09 Layout and routing Power and initial signals, SD card
    [hmi_microcontroller.kicad_sch, minstro_combined_board.kicad_pcb, mpu_audio.kicad_sch, mpu_battery.kicad_sch, mpu_microcontroller.kicad_sch, mpu_power.kicad_sch]
2025-06-10 Routing mostly completed
    [minstro_combined_board.kicad_pcb, minstro_combined_board.kicad_sch, mpu_connectors.kicad_sch, mpu_microcontroller.kicad_sch]
2025-06-11 PCB size fix started
    [hmi_nav_switch.kicad_sch, hmi_vfo.kicad_sch, minstro_combined_board.kicad_pcb]
2025-06-12 Board resizing
    [hmi_microcontroller.kicad_sch, minstro_combined_board.kicad_pcb]
2025-06-12 Layout completed, initial review
    [hmi_microcontroller.kicad_sch, hmi_nav_switch.kicad_sch, hmi_vfo.kicad_sch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]
2025-06-12 Move slot and begin re-layout
    [minstro_combined_board.kicad_pcb, mpu_microcontroller.kicad_sch]
2025-06-13 Adjust connector positions, thicken Vusb traces, move onboard microphone, improve silkscreen
    [minstro_combined_board-B_Cu.gbr, minstro_combined_board-B_Mask.gbr, minstro_combined_board-B_Paste.gbr, minstro_combined_board-B_Silkscreen.gbr, minstro_combined_board-Edge_Cuts.gbr, minstro_combined_board-F_Cu.gbr, minstro_combined_board-F_Mask.gbr, minstro_combined_board-F_Paste.gbr]
2025-06-24 HMI processor firmware started
    [hmi_microcontroller.kicad_sch, hmi_nav_switch.kicad_sch, mpu_battery.kicad_sch]
2025-06-26 Bringup WIP. I2C enumerating.
    [minstro_combined_board.kicad_pcb, mpu_audio.kicad_sch, mpu_microcontroller.kicad_sch]
2025-06-28 Improvements in SD card bring up test, board and mode defines in code for easier iteration.
    [mpu_microcontroller.kicad_sch]
